linux4life798/business-card/docs/business-card-schematic.pdf

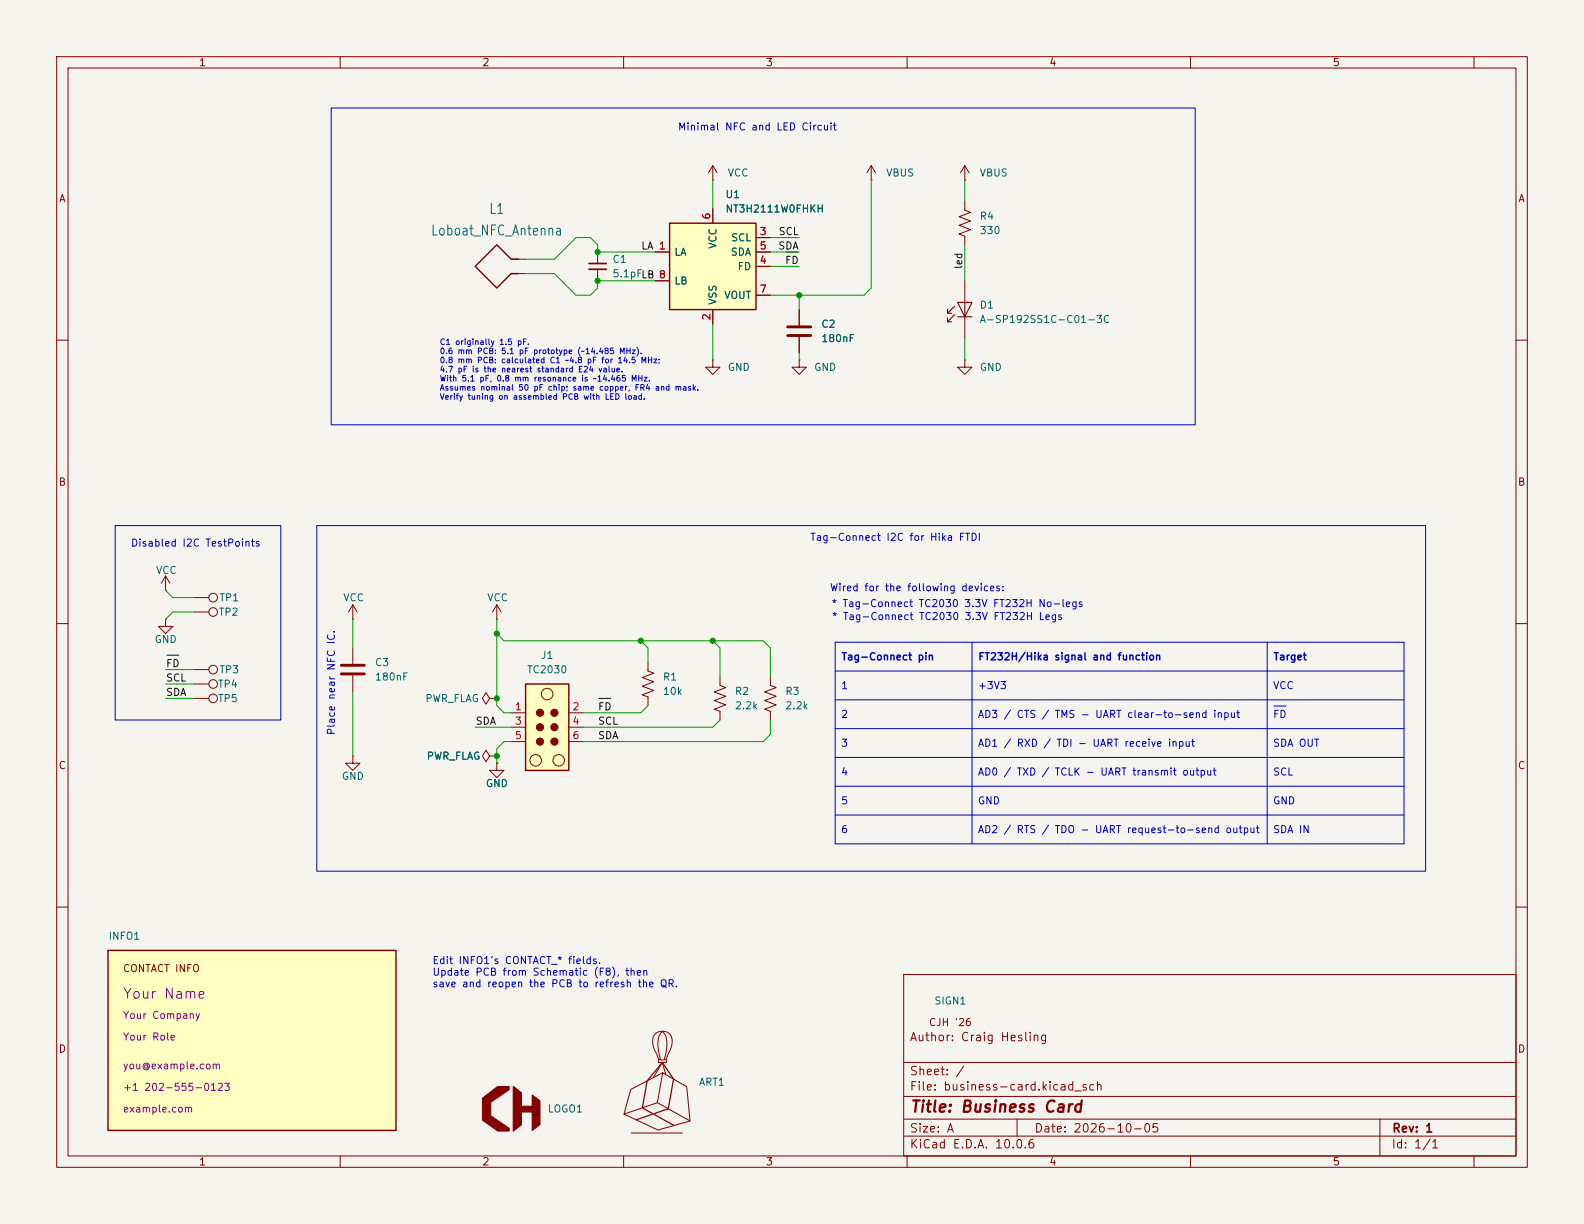
[picture p3: page 1]

Tag-Connect pin | +3V3 FT232H/Hika signal and function | VCC Target 1

2 | AD3 / CTS / TMS - UART clear-to-send input | FD

Your Company Your Role

Size: A | Rev: 1
KiCad E.D.A. 10.0.6 | Id: 1/1
