linux4life798/business-card/business-card.kicad_pcb

## KiCad design business-card.kicad_pcb (2026-10-16)

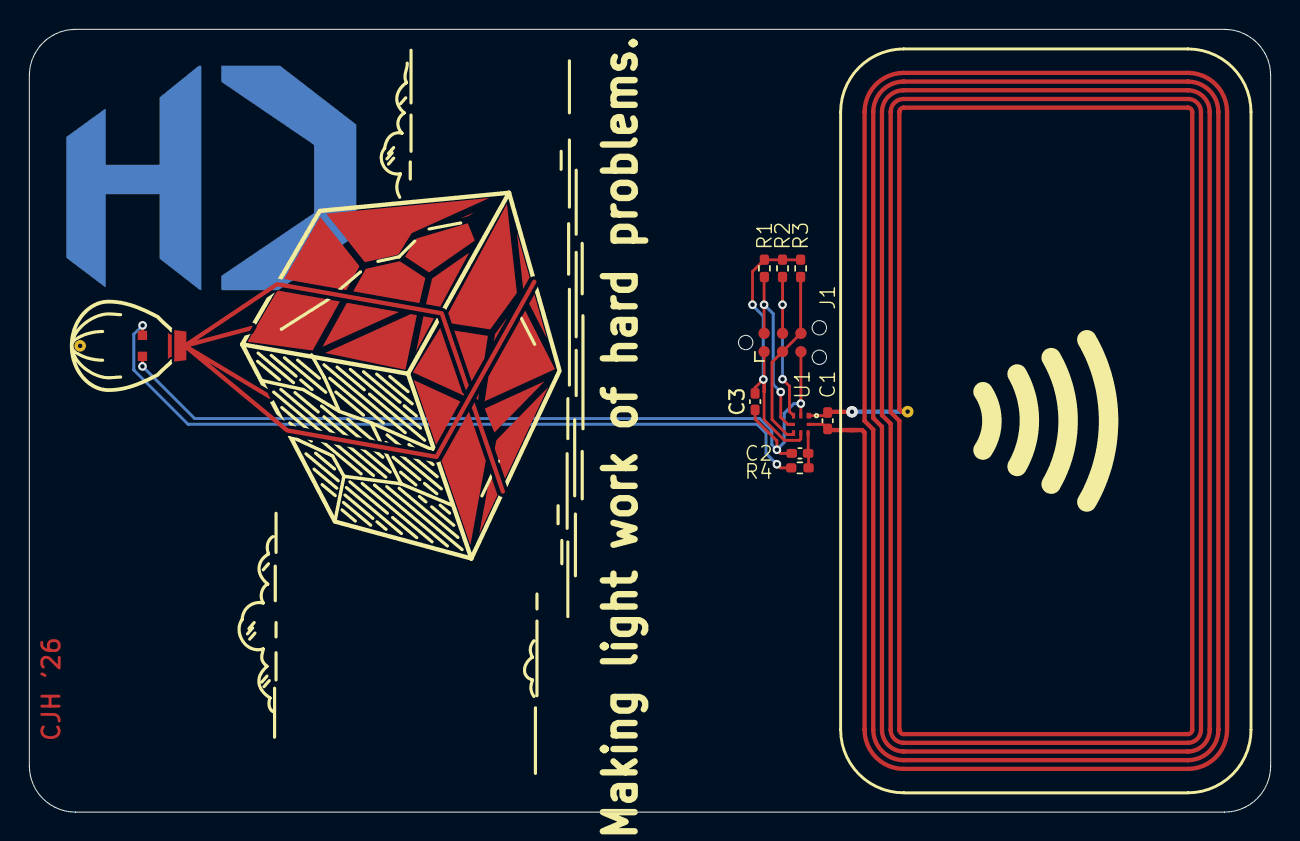
[picture p4: board business-card.kicad_pcb from above]

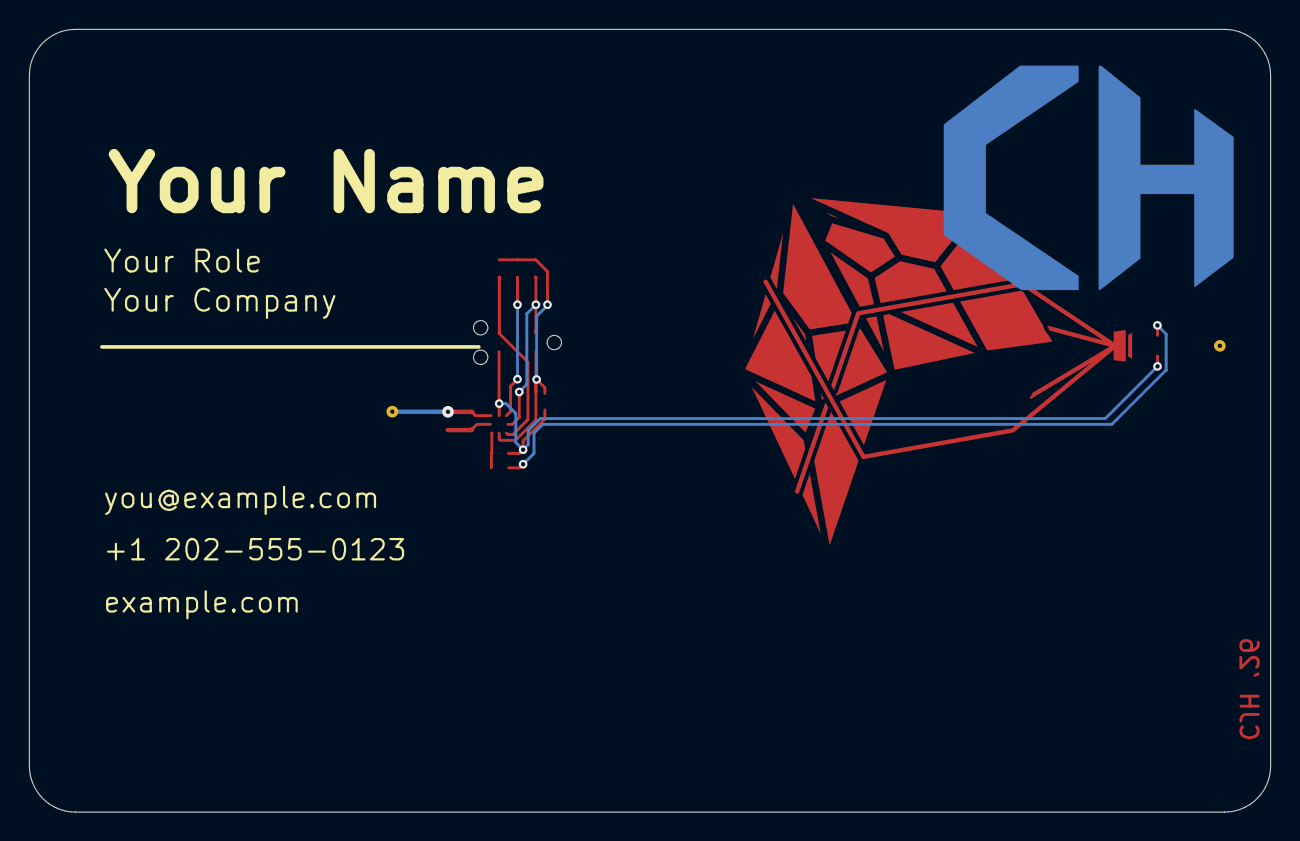
[picture p5: board business-card.kicad_pcb from below]

Board: 2 copper layers, 85.6 x 54.0 mm, 15 parts (2 on the bottom side), 9 nets.

Parts:
ART1: LanternLift_GiftWrap; LanternLift_GiftWrap_Copper_SilkScreen
C1: 5.1pF; C_0402_1005Metric_Pad0.74x0.62mm_HandSolder
C2, C3: 180nF; C_0402_1005Metric_Pad0.74x0.62mm_HandSolder
D1: A-SP192SS1C-C01-3C; Amicc_A-SP192SS1C-C01-3C_SideView
INFO1: Contact_Info; Contact_Info_SilkScreen
J1: TC2030; Tag-Connect_TC2030-IDC-NL_2x03_P1.27mm_Vertical
L1: Loboat_NFC_Antenna; Loboat_NFC_Antenna_48x25mm_5Turns
LOGO1: CH_Logo; CH_Logo_20mm_Copper
R1: 10k; R_0402_1005Metric_Pad0.72x0.64mm_HandSolder
R2, R3: 2.2k; R_0402_1005Metric_Pad0.72x0.64mm_HandSolder
R4: 330; R_0402_1005Metric_Pad0.72x0.64mm_HandSolder
SIGN1: CJH_Signature; CJH_Signature_Copper_Masked
U1: NT3H2111W0FHKH; NXP_SOT902-3_XQFN-8_1.6x1.6mm

Connections:
/LA: C1.1, L1.P$2, U1.1 (LA)
/LB: C1.2, L1.P$1, U1.8 (LB)
/SCL: J1.4, R2.2, U1.3 (SCL)
/SDA: J1.3, J1.6, R3.2, U1.5 (SDA)
/led: D1.1 (A), R4.2
/~FD: J1.2, R1.2, U1.4 (FD)
GND: C2.2, C3.2, D1.2 (K), J1.5, U1.2 (VSS)
VBUS: C2.1, R4.1, U1.7 (VOUT)
VCC: C3.1, J1.1, R1.1, R2.1, R3.1, U1.6 (VCC)
