linux4life798/business-card/(commit log)

2026-10-06 Add blank kicad project
    [business-card.kicad_pcb, business-card.kicad_sch]
2026-10-06 Add some page metadata
    [business-card.kicad_pcb, business-card.kicad_sch]
2026-10-06 Add empty local symbol and footprint libraries
2026-10-06 Placed the CH logo in schematic and pcb
    [business-card.kicad_pcb, business-card.kicad_sch]
2026-10-06 Add credit card board outline and getting started components
    [business-card.kicad_pcb, business-card.kicad_sch]
2026-10-06 Place the contactless tap icon
    [business-card.kicad_pcb, business-card.kicad_sch]
2026-10-06 Add contact info symbol and footprint
2026-10-06 Add Pb-free and RoHS symbol and footprint markings
    Add pinless schematic symbols linked to matching 10 mm front-silkscreen
    footprints. Exclude both markings from BOM and placement output.
2026-10-06 Add TC2030 symbol and legged and no-legs footprints
    Tag-Connect TC2030 library assets
    Source: KiCad Community symbol and footprint libraries, version 10.0.6
    (Debian packages kicad-symbols and kicad-footprints 10.0.6-1).
    Imported assets:
    - Connector:TC2030, now business-card:TC2030
    - Connector:Tag-Connect_TC2030-IDC-FP_2x03_P1.27mm_Vertical (legged)
    - Connector:Tag-Connect_TC2030-IDC-NL_2x03_P1.27mm_Vertical (no legs)
    Upstream sources:
    https://gitlab.com/kicad/libraries/kicad-symbols/-/blob/10.0.6/Connector.kicad_sym
    https://gitlab.com/kicad/libraries/kicad-footprints/-/tree/10.0.6/Connector.pretty
    Local changes: the symbol defaults to the project-local no-legs footprint;
    its TC2030 footp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
2026-10-06 Add alternate RoHS footprint from ViewSonic article artwork
    Trace the sweeping checkmark and RoHS lettering as 10 mm wide
    silkscreen polygons. Preserve the original footprint as the default
    with the per-symbol selection workflow below.
    RoHS marking alternative from the ViewSonic article
    Asset: business-card:RoHS_Logo_ViewSonic_10mm_SilkScreen
    Source article:
    https://www.viewsonic.com/library/education/product-certification-matters/
    Source artwork (187 x 188 pixel JPEG):
    https://www.viewsonic.com/library/wp-content/uploads/2019/04/RoHS_mark-6.jpg
    SHA-256: 9b6a69f726b3c03b2de018ab5918f9f1a53ea5998c46185aa360e5afa0dba869
    Adaptation: the article's sweeping checkmark and RoHS lettering are t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
2026-10-06 Align RoHS symbol and default footprint with sweeping-check artwork
    Use the ViewSonic-style footprint by default and match the schematic
    symbol to its traced artwork. Move the reference clear of the logo
    and retain the circular footprint alternative.
    The RoHS_Logo symbol uses this asset as its default footprint. Its
    RoHS_Logo_*_SilkScreen filter also includes the original circular
    RoHS_Logo_10mm_SilkScreen footprint as an alternative. The schematic
    symbol uses the same traced polygons at the same size, with the Y axis
    converted to schematic coordinates. Both views preserve the letter openings.
    For an existing placed symbol, set its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
2026-10-06 Revert "Add TC2030 symbol and legged and no-legs footprints"
    This reverts commit 1ccd64e674cc317394795b235612734f82146b1e.
2026-10-07 Add NT3H2111W0FHKH symbol and NXP XQFN8 footprint
    Add a project-local symbol with functional pin placement, electrical pin
    roles, and a link to the new SOT902-3 footprint. SCL and SDA are
    bidirectional; SCL supports clock stretching. FD is open drain.
    Draw the footprint from NXP dimensions with the wider pin-1 copper land,
    separate paste apertures at their nominal centers, a pin-1 marker, and a
    0.5 x 0.5 mm central copper keepout. The center metal is not solderable.
    The 0.025 mm solder-mask expansion is a library design choice.
    Sources:
    - NXP NT3H2111_2211 Rev. 3.6, Table 3 and Figures 3, 31, and 32:
    https://www.nxp.com/docs/en/data-sheet/NT3H2111_2211.pdf
    - Solder-land versus paste shad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
2026-10-07 Add linked NXP SW3639 Class 4 PCB antenna to local library
    Add NXP_NTAG_Class4_Antenna with passive ANT1/ANT2 pins and the matching
    business-card:NXP_NTAG_Class4_Antenna_54x27mm_3Turns footprint. Source maps
    ANT1 to the NTAG LA input and ANT2 to LB.
    Preserve the NXP three-turn coil copper, terminal lands, plated holes,
    solder-mask openings and 0.30 mm trace / 0.95 mm gap. Model the intentional
    DC-continuous coil with a two-terminal net tie. Rename the internal plated
    holes ANT2 and convert the bottom crossover into an identical ANT2 custom
    pad, so KiCad checks its physical connectivity without duplicate-pad
    jumper shortcuts. Remove stencil paste and exclude the printed antenna
    from the asse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
2026-10-08 Add SOT902-3 3D body for NT3H2111W0FHKH
    Add a colored STEP model and its FreeCAD generator, linked from the local
    NXP XQFN8 footprint through a portable project-relative path.
    The model has a 1.60 x 1.60 mm nominal outline and the specified 0.50 mm
    maximum height, eight contacts including stepped pin 1, and the physical
    0.30 x 0.30 mm unsoldered center metal. Pin 1 is marked on the top face.
    The contact seating plane is Z=0 with unit scale and no footprint offset.
    Source: independently drawn from NXP NT3H2111_2211 Rev. 3.6, Figure 31:
    Model assumptions are documented in the generator: 0.025 mm body standoff
    (midpoint of the specifie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
2026-10-14 First workable version and extra art
    * Most components are in the right place and the PCB is routed
    * Tag-connect is still enabled and placed/routed
    * Board/schematic is customized for CH, but contact info is example data
    * Lots of extra symbols and footprints containing alternative art
    * Many alternative components
    * A few PCB DRC errors remain to be resolved
    [business-card.kicad_pcb, business-card.kicad_sch]
2026-10-14 Change cjh signature and CH logo default footprint
    This change snagged some other library changes, too, but functionally
    it only makes those two changes.
    [business-card.kicad_pcb, business-card.kicad_sch]
2026-10-14 Add schematic preview to README.md
2026-10-14 Add Author to schematic and pcb sheets
    [business-card.kicad_pcb, business-card.kicad_sch]
2026-10-14 Regenerate pcb renderings
2026-10-14 Tune board for JLCPCB 0.6mm economy service
    [business-card.kicad_pcb]
2026-10-14 Increase ART1 annular ring to 0.25 mm
    Avoids JLCPCB fab constraints
    [business-card.kicad_pcb]
2026-10-14 Set C1 to 5.1 pF for NFC tuning prototype
    The original 1.5pF, I believe, came from an online ST or NXP tool.
    The new value comes from FastHenry and FastCap analysis of the actual
    PCB coil, feed traces, and nearby copper. Combining the estimated
    inductance and parasitic capacitance with the NT3H2111’s nominal 50 pF
    input capacitance gives approximately 5.0 pF for NXP’s recommended
    14.5 MHz tuning target.
    The 5.1 pF used in the schematic predicts a nominal resonance of
    approximately 14.48 MHz.
    [business-card.kicad_pcb, business-card.kicad_sch]
2026-10-14 Update and merges drc for PCBWAY, too
    [business-card.kicad_pcb]
2026-10-14 Update readme renderings and schematic
2026-10-14 Document NFC tuning sensitivity to PCB thickness
    [business-card.kicad_sch]
2026-10-14 Regenerate README schematic SVG and PDF
2026-10-15 Move contact details to project variables scope
    Edit these either in the kicad_pro file OR graphically from the schematic
    or PCB setup menu.
    [business-card.kicad_pcb, business-card.kicad_sch]
2026-10-15 Move qr code to library footprint
    [business-card.kicad_pcb]
2026-10-15 Update from library
    [business-card.kicad_pcb, business-card.kicad_sch]
2026-10-15 Use schematic INFO1 as the source for contact personalization
    Drive footprint text and the native QR from CONTACT_* fields, replacing
    the project-variable aliases. Read INFO1 defaults in the finalizer and
    synchronize the output schematic, PCB, QR, vCard and NFC data.
    Document the KiCad QR refresh step and regenerate design previews.
    [business-card.kicad_pcb, business-card.kicad_sch]
2026-10-16 Remove silkscreen from sideway led footprint lib and pcb
    It looks better in the baloon withotu silkscreen.
    [business-card.kicad_pcb]
2026-10-16 Add additional decoupling cap to tag-connect vcc supply
    Not the best placement and routing, but this will be
    disabled after debugging.
    [business-card.kicad_pcb, business-card.kicad_sch]
