linux4life798/business-card/(notices)

Notices in the files:
parts and their libraries:
Loann Boudin NFC antenna, 48x25 mm, 5 turns; Eagle conversion, CC BY-NC-SA 4.0
License: CC BY-NC-SA 4.0; https://creativecommons.org/licenses/by-nc-sa/4.0
